loopmasta/rdio/README.md

# rdio

**rdio** turns your iPhone into a VHF/UHF radio. It connects to one or more ESP32-powered devices equipped with radio modules over Wi-Fi. Listen to transmissions, talk with push-to-talk, save your favourite channels and repeaters, and exchange APRS messages in a familiar chat-style interface.

**[Get the app on the App Store](https://apps.apple.com/de/app/rdio/id6831735571?l=en-GB)**

<table>
  <tr>
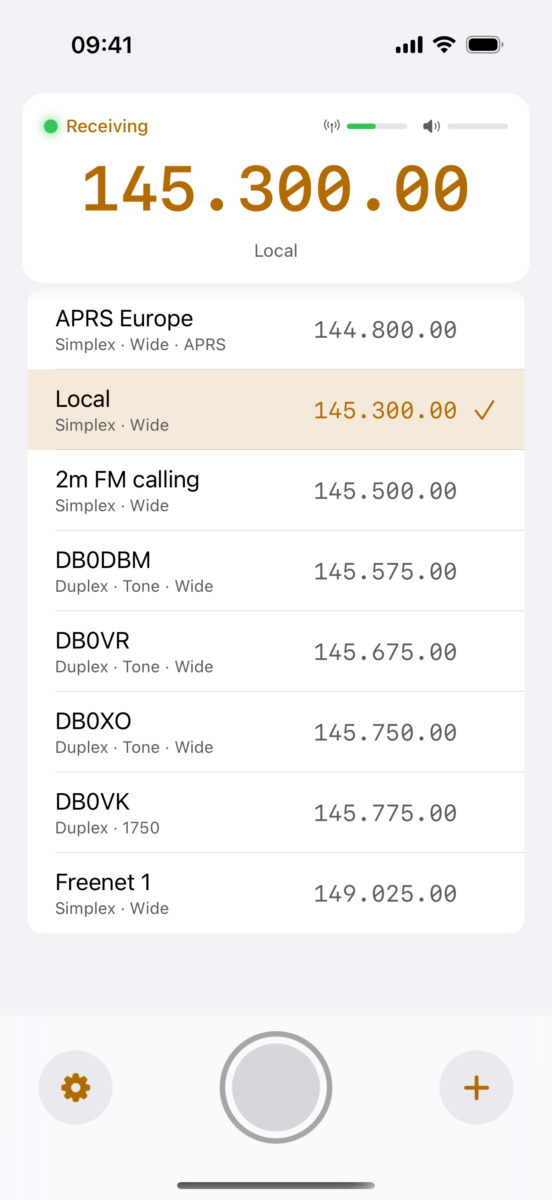
[picture p1: docs/1-main.png]
Main screen: frequency, signal and audio meters, channel list
    <td align="center"></td>
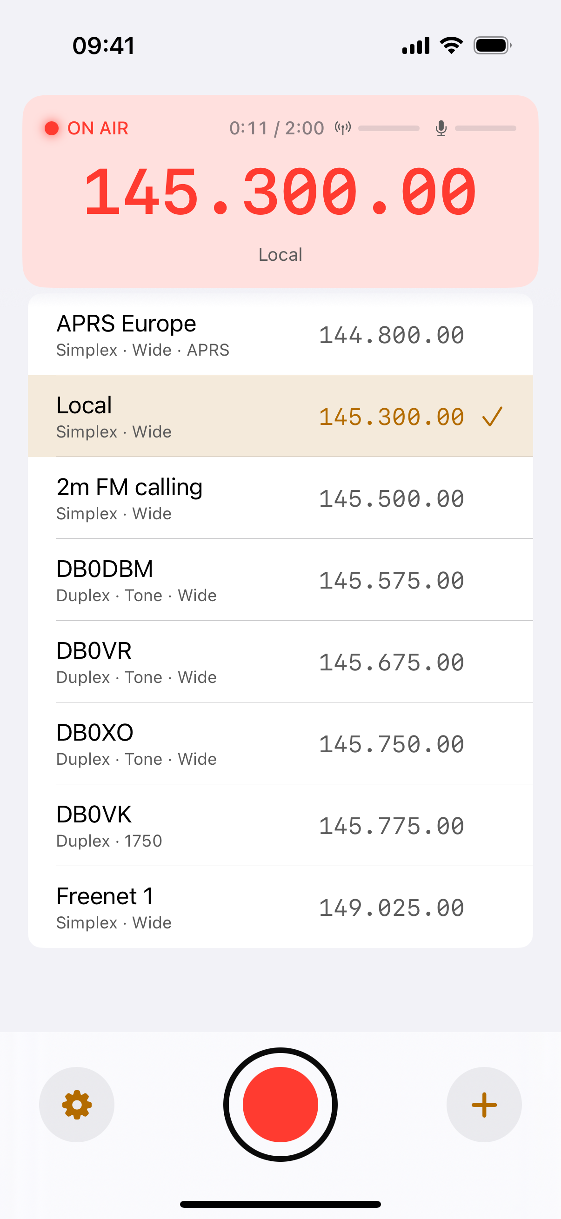
[picture p2: docs/2-transmit.png]
Transmitting: push-to-talk
    <td align="center"></td>
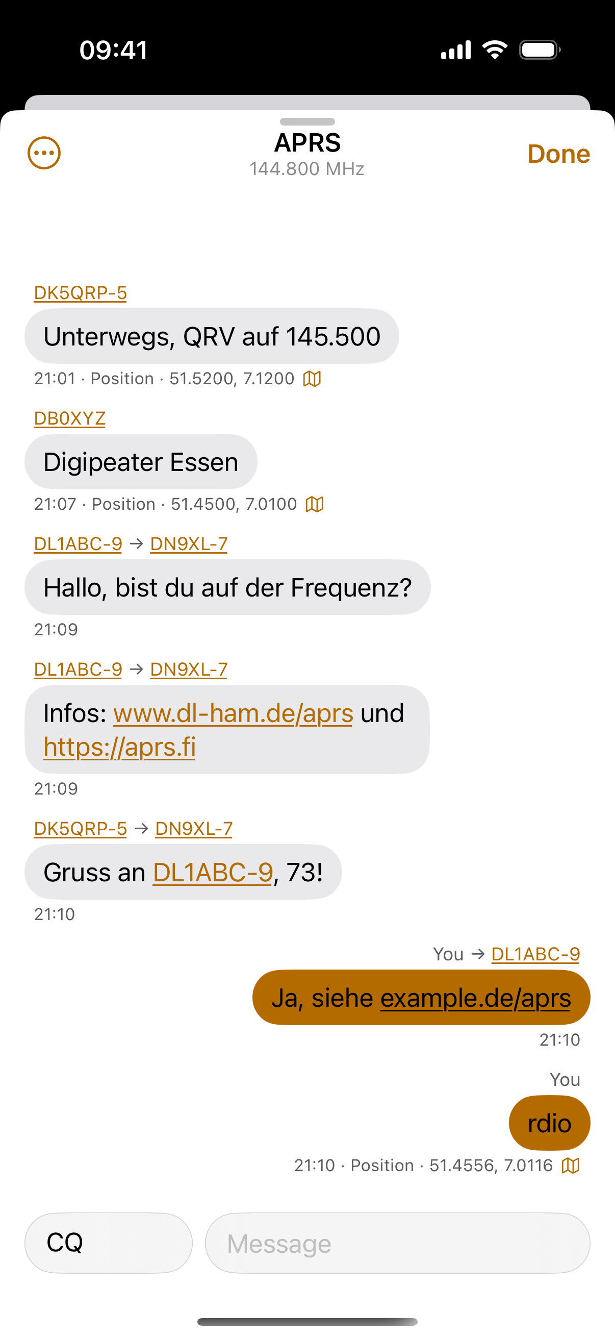
[picture p3: docs/3-aprs.png]
APRS chat with heard stations
    <td align="center"></td>
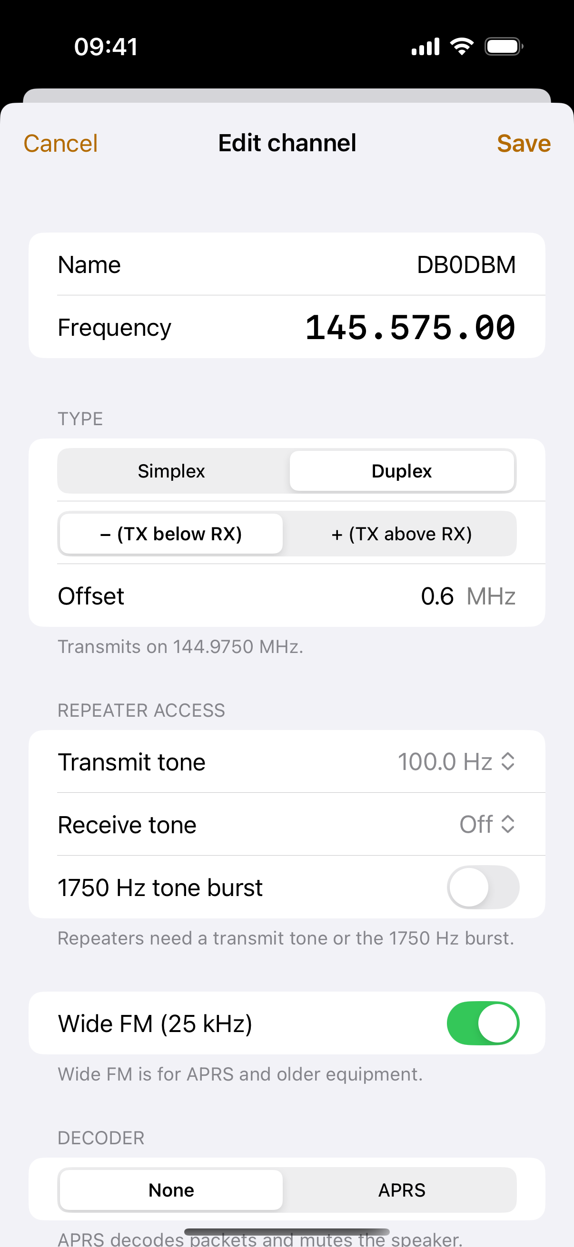
[picture p4: docs/4-editor.png]
Channel editor: frequency, simplex or duplex, tones, tone burst
    <td align="center"></td>
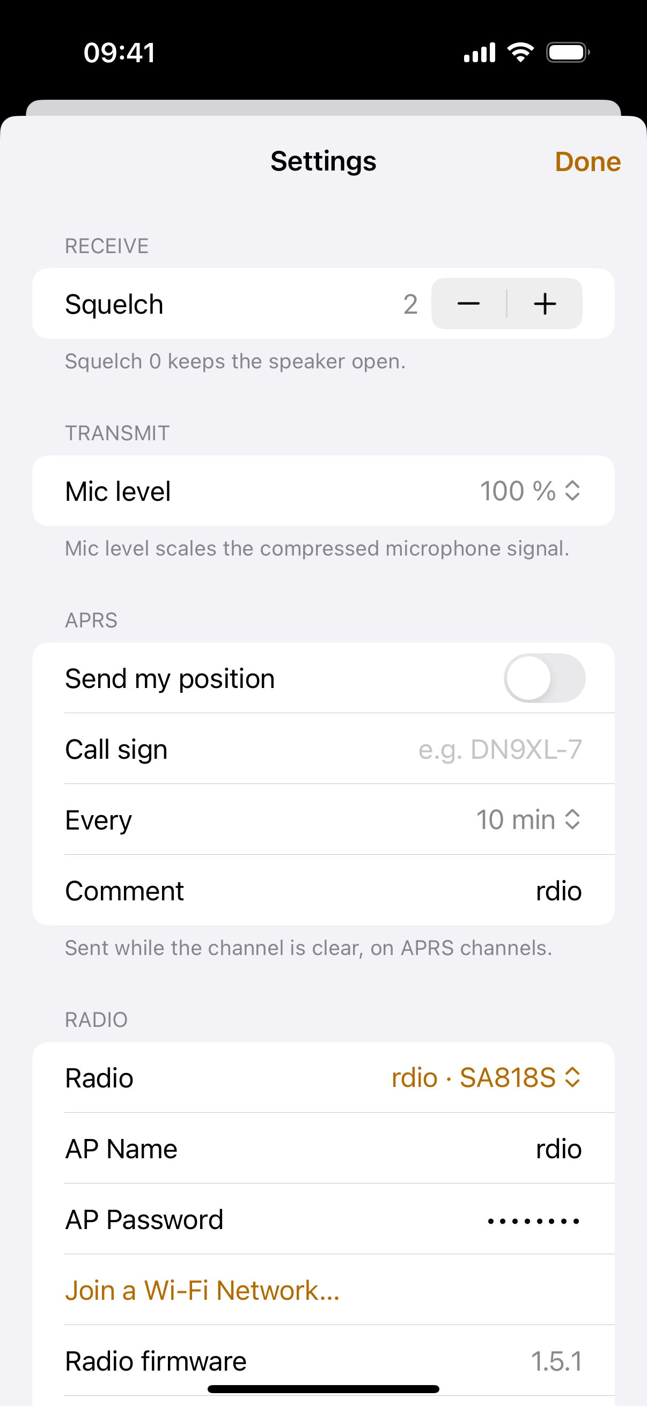
[picture p5: docs/5-settings.png]
Settings sheet: APRS beacon and radio
    <td align="center"></td>
  </tr>
  <tr>
    <td align="center">Main screen</td>
    <td align="center">Transmit</td>
    <td align="center">APRS chat</td>
    <td align="center">Channel editor</td>
    <td align="center">Settings</td>
  </tr>
</table>

## How it works

- The ESP32 opens its own Wi-Fi network (or joins one you configure). The phone connects to it and talks to the radio over a WebSocket. Radios on a shared network are found automatically (Bonjour), so one app can control several of them.
- Receive audio goes from the radio to the phone as 16 kHz mono PCM. Transmit audio goes the other way while you hold the push-to-talk button.
- The module is tuned, squelched and keyed by the ESP32 through its UART, PTT and power-down lines.
- Bluetooth is not used.

## Features

- **Receive and transmit** in the selected band (VHF 134–174 MHz or UHF 400–480 MHz).
- **Channel list** with simplex and duplex (repeater) entries, shift direction and offset, CTCSS transmit and receive tones, and a 1750 Hz tone burst. Reorder by dragging, swipe to edit or delete.
- **APRS** on 1200 baud AFSK: the app decodes received packets (positions, Mic-E, messages, status) on APRS channels, shows them as a chat with distance and a link to Maps, links call signs to QRZ.com. You can also send: type a message in the chat to a call sign or to CQ. Messages to a station are repeated until it acknowledges them, the app acknowledges messages addressed to you, and everything is sent only while the channel is clear. A periodic position beacon is available too.
- **Several radios:** each radio announces itself on the network as a Bonjour service (`_rdio._tcp`, with its name, module type and firmware version). The app lists the radios it finds in Settings → Radio and switches between them with one tap. Give every radio its own name (Settings → Radio Name), because the name is also its Wi-Fi and host name.
- **Phone microphone chain** with a compressor and a mic level setting, soft limiter on the radio side.
- **Native iOS design**: system controls, Light and Dark Mode, Dynamic Type, VoiceOver, haptics, no navigation bar.
- **Transmit safety**: the app only transmits inside the selected band, and the firmware releases the push-to-talk line when the connection drops, when no audio arrives, and after 120 seconds. Only one client can transmit.
- **Transmit power:** high (1 W) or low (0.5 W) with a switch in Settings → Radio. The radio remembers the choice; low power draws about half as much from the battery while transmitting.
- Firmware updates over Wi-Fi.

## Status

Working on a real radio: receive, transmit, channel handling, tones, tone burst, APRS decoding, and the APRS position beacon (tested over the air).

Not done yet: a scan function in the app.

The carrier board is built and works: receive, transmit, the transmit audio level and the power switch were tested on the air. The harmonic filters below are **designed but not built or measured yet**. They are simulated only; check them with a NanoVNA before relying on them.

## Hardware

Everything is KiCad 10 and is generated by scripts, so the boards can be rebuilt and changed in code.

### Carrier board

A 57.3 × 25.4 mm two-layer board for an ESP32 38-pin DevKit (NodeMCU-32S style) and a DRA818 / SA818 module. The DevKit's own pins are soldered into the board from below, the radio module sits on the top side, and an SMA jack on the end opposite the DevKit's USB port carries the antenna signal on a short track.

<table>
  <tr>
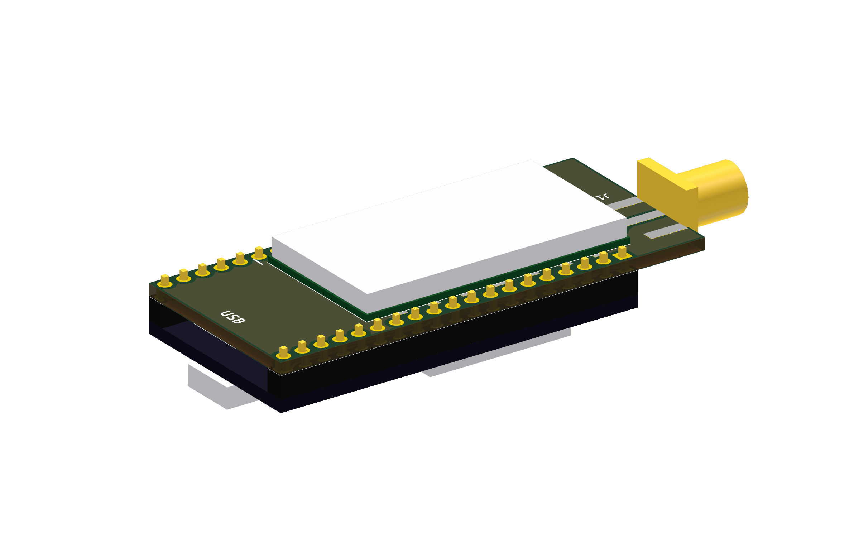
[picture p6: hardware/rdio-pcb-3d.png]
Top side of the carrier board with the radio module, the DevKit below and the SMA jack
    <td align="center"></td>
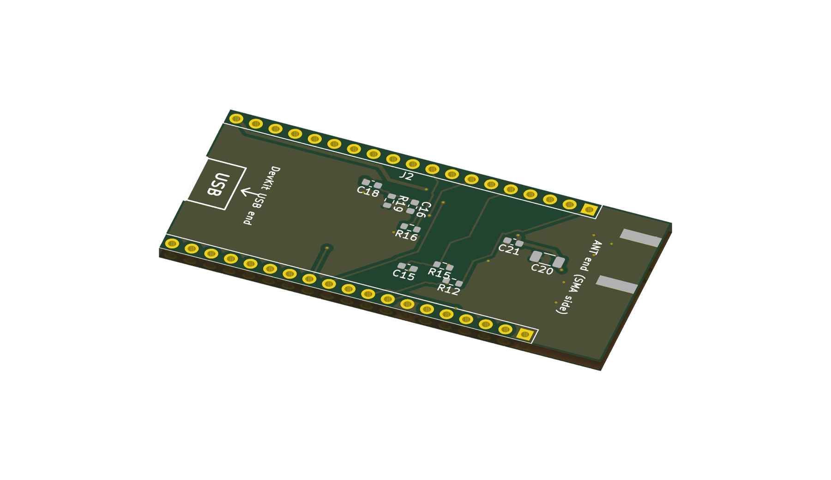
[picture p7: hardware/rdio-pcb-bottom.png]
Bottom side of the carrier board with the audio and supply parts and the DevKit pin rows
    <td align="center"></td>
  </tr>
  <tr>
    <td align="center">Top: radio module, DevKit below, SMA jack</td>
    <td align="center">Bottom: audio and supply parts, DevKit pin rows</td>
  </tr>
</table>

| Function | ESP32 pin |
|---|---|
| Module UART (RX / TX) | GPIO16 / GPIO17 |
| Power down (high = on) | GPIO19 |
| PTT (low = transmit) | GPIO18 |
| Squelch in | GPIO32 |
| RX audio in (ADC) | GPIO34, biased to 1.75 V by GPIO26 |
| TX audio out | GPIO25 |
| High / low power | GPIO23 (the firmware pulls it low for 0.5 W and leaves it floating for 1 W; it never drives it high) |

- The module's supply pin is fed straight from the DevKit's 5 V pin, with a 47 µF and a 100 nF capacitor next to the module. The module's datasheet allows 3.3 to 4.5 V, so check the voltage on your DevKit's 5 V pin (many boards drop it through a diode from USB) before the first power-up.
- Pin numbers, the module name and the antenna end are printed on the top silkscreen inside the module outline, to help with placing it.
- Test status: built and working. The module's footprint and the DevKit's pin spacing were checked against real parts. The transmit network (22 k in series, 220 Ω and 220 nF to ground) divides the signal by about 100 and rolls it off from a few hundred hertz, so the firmware compensates with a higher transmit gain and a first-order treble boost (`firmware/idf/main/board.h`); the level and the frequency response were checked through a second radio.

### Harmonic filters (2 m and 70 cm)

Two small all-SMD low-pass filters (7th-order Chebyshev, 0.1 dB ripple, 50 Ω) that go between the board's SMA jack and the antenna and cut the radio module's harmonics. Details, simulation and parts notes: [hardware/filter/README.md](hardware/filter/README.md).

<table>
  <tr>
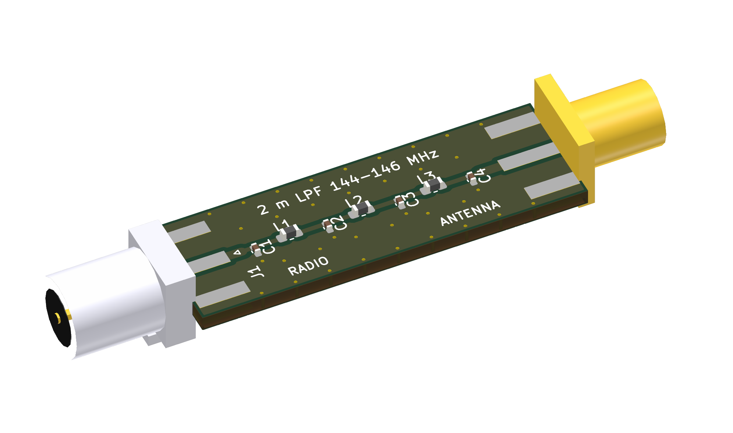
[picture p8: hardware/filter/vhf/rdio-filter-vhf-3d.png]
2 m low-pass filter board
    <td align="center"></td>
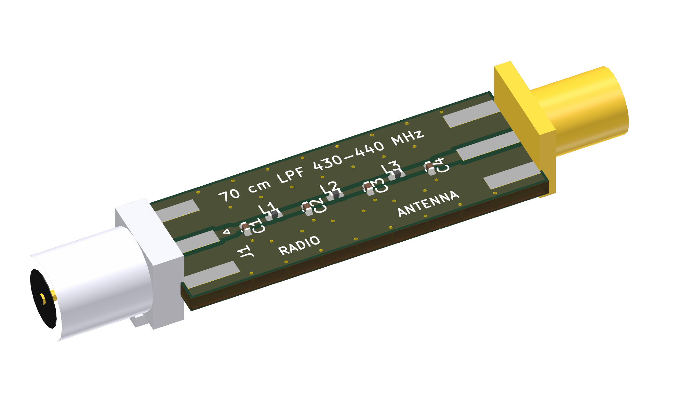
[picture p9: hardware/filter/uhf/rdio-filter-uhf-3d.png]
70 cm low-pass filter board
    <td align="center"></td>
  </tr>
  <tr>
    <td align="center">2 m, 144–146 MHz</td>
    <td align="center">70 cm, 430–440 MHz</td>
  </tr>
</table>

| | 2 m | 70 cm |
|---|---|---|
| Passband | 144–146 MHz | 430–440 MHz |
| Insertion loss (simulated) | 0.56 dB | 0.50 dB |
| 2nd harmonic (simulated) | 52 dB down | 63 dB down |
| Board size | 38.0 × 12.4 mm | 34.4 × 12.4 mm |

### Ordering the boards

Gerber, drill, bill of materials and placement files for JLCPCB are in [hardware/jlcpcb/](hardware/jlcpcb/): `radio/` for the carrier board and `filters/vhf`, `filters/uhf` for the filters. Check the LCSC part numbers in the bills of materials against JLCPCB's parts library before you order. The SMA connectors, the DevKit headers and the radio module are soldered by hand.

## Legal

Transmitting needs an amateur radio licence and must follow the rules that apply to you. The app limits the transmit frequency to the selected band, but you are responsible for staying within your licence and the local regulations.

**Privacy:** the app has no accounts, analytics or tracking. See the [privacy policy](https://loopmasta.github.io/rdio/privacy/).

## Repository contents

This repository lets a small group of testers order the hardware, build it, flash the firmware and install the app, with no software knowledge or development tools. It holds the hardware design (`hardware/`), the screenshots (`docs/`) and this description.

The software is not included and does not need to be built:

- **iOS app:** [download rdio from the App Store](https://apps.apple.com/de/app/rdio/id6831735571?l=en-GB).
- **Firmware:** installed from your browser with the [web flasher](https://loopmasta.github.io/rdio/flash/). Connect the ESP32 over USB, open the page in Chrome or Edge on a computer and press install.
