loopmasta/rdio/hardware/filter/uhf/rdio-filter-uhf-top.png

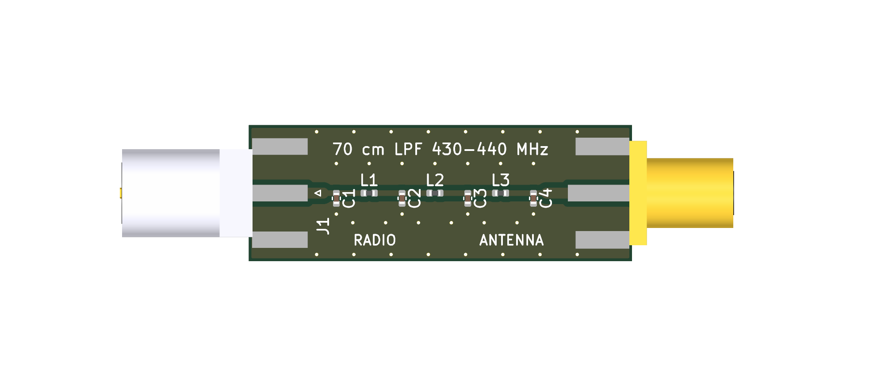
hardware/filter/uhf/rdio-filter-uhf-top.png
