loopmasta/rdio/hardware/rdio-pcb-top.png

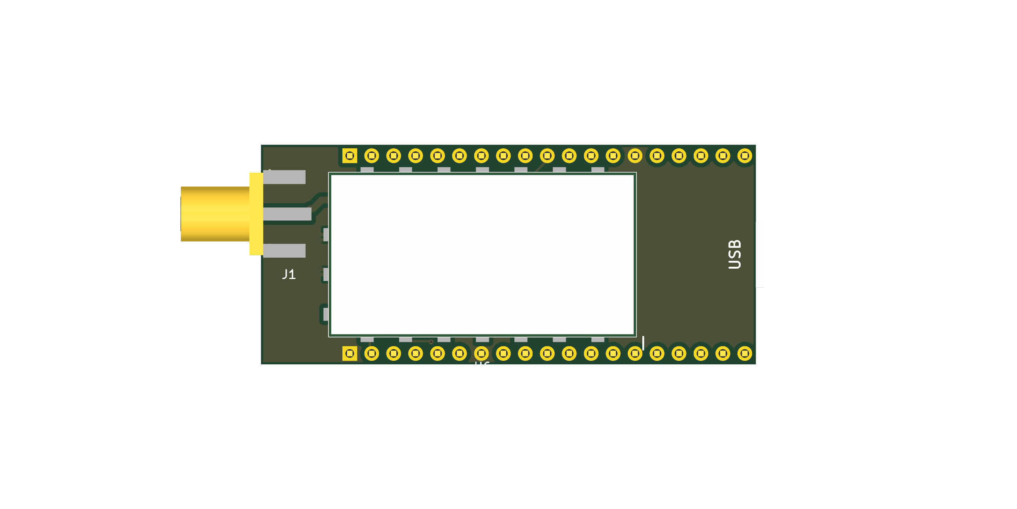
hardware/rdio-pcb-top.png
