loopmasta/rdio/hardware/jlcpcb/radio/bom.csv

Comment | Designator | Footprint | LCSC Part #
1uF | C15 | C_0603_1608Metric | C15849
220nF | C16 | C_0603_1608Metric | C23630
100nF | C18,C21 | C_0603_1608Metric | C14663
47uF | C20 | C_1206_3216Metric | C96123
10k | R12,R15 | R_0603_1608Metric | C25804
22k | R16 | R_0603_1608Metric | C31850
220R | R19 | R_0603_1608Metric | C22962
