loopmasta/rdio/hardware/rdio-schematic.pdf

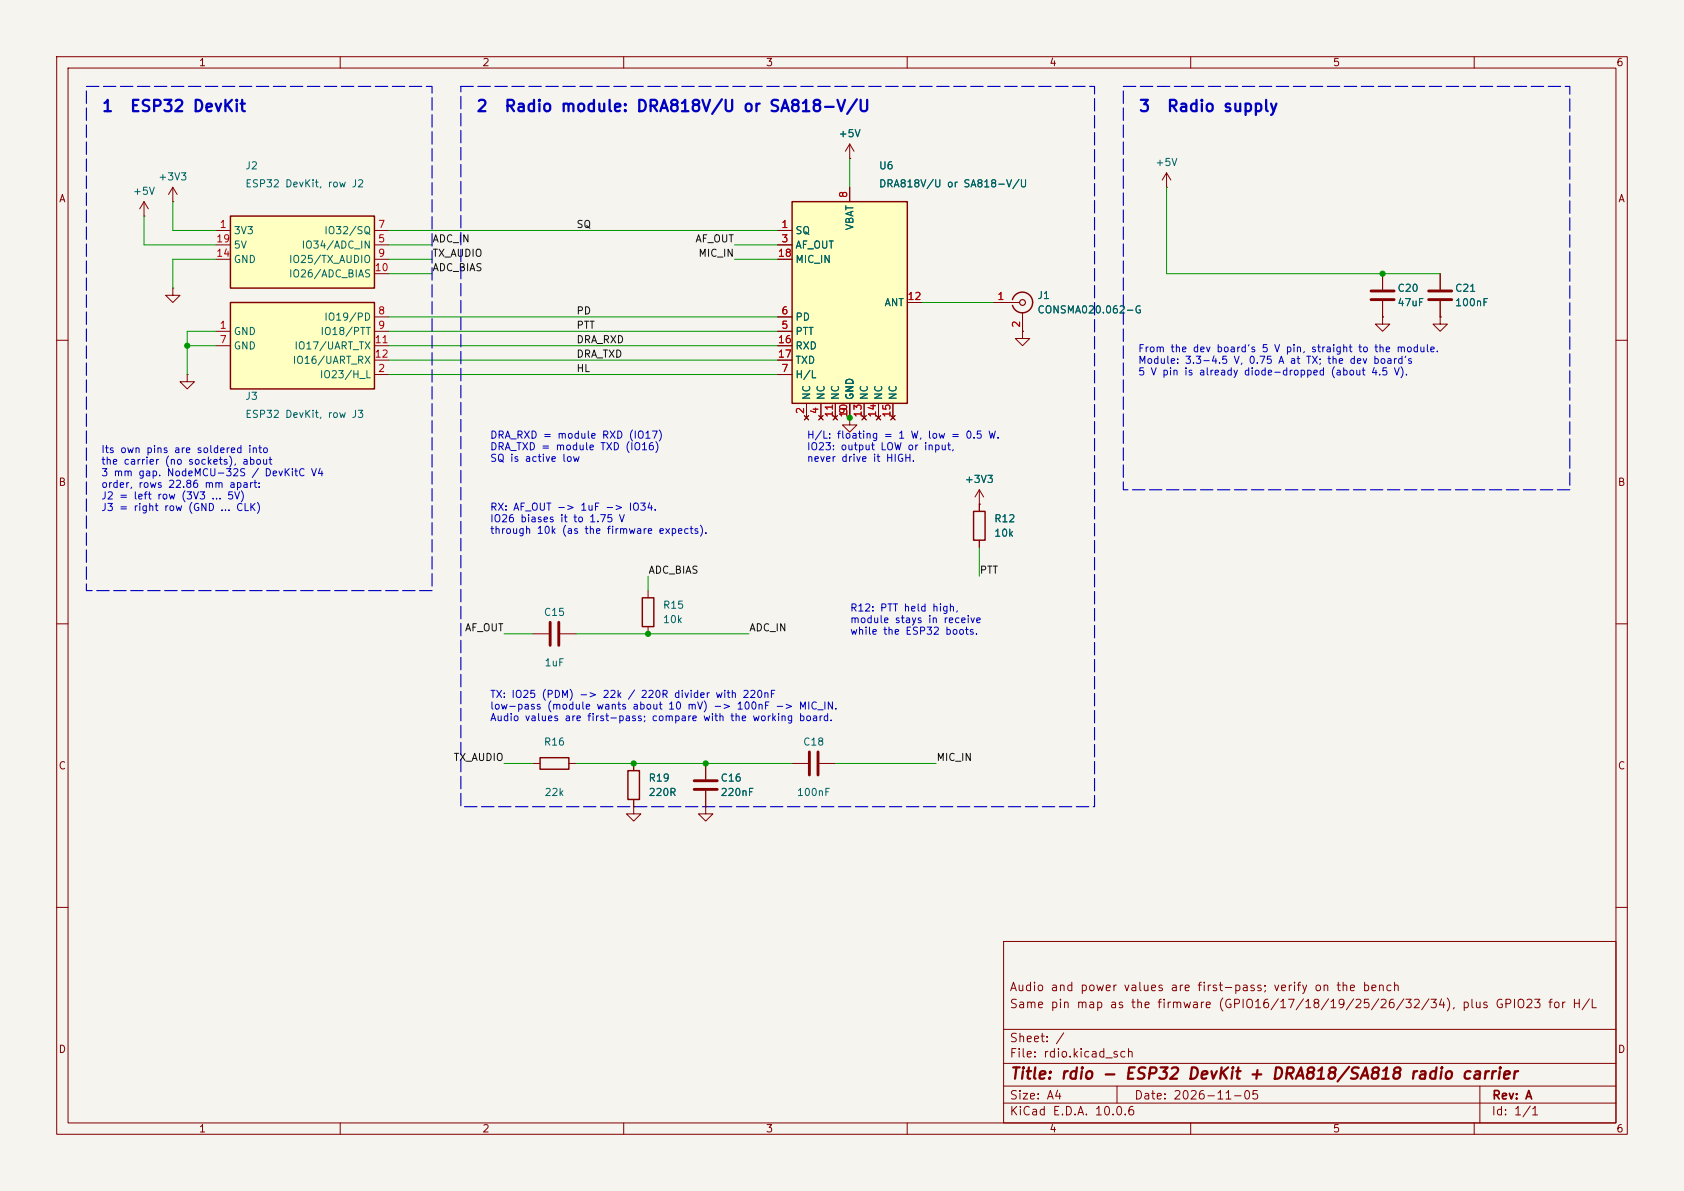
[picture p14: page 1]

4 PTT 5 PD 6 H/L 7 VBAT 8 GND

Its own pins are soldered into
the carrier (no sockets), about 3 mm gap. NodeMCU-32S / DevKitC V4

IO23: output LOW or input, never drive it HIGH. TX: IO25 (PDM) -> 22k / 220R divider with 220nF

R12: PTT held high, module stays in receive while the ESP32 boots. RX: AF_OUT -> 1uF -> IO34.
IO26 biases it to 1.75 V

low-pass (module wants about 10 mV) -> 100nF -> MIC_IN. Audio values are first-pass; compare with the working board.

Audio and power values are first-pass; verify on the bench
Same pin map as the firmware (GPIO16/17/18/19/25/26/32/34), plus GPIO23 for H/L

Sheet: /
File: rdio.kicad_sch
Title: rdio - ESP32 DevKit + DRA818/SA818 radio carrier

Size: A4 | Rev: A
KiCad E.D.A. 10.0.6 | Id: 1/1
