loopmasta/rdio/hardware/filter/uhf/rdio-filter-uhf-schematic.pdf

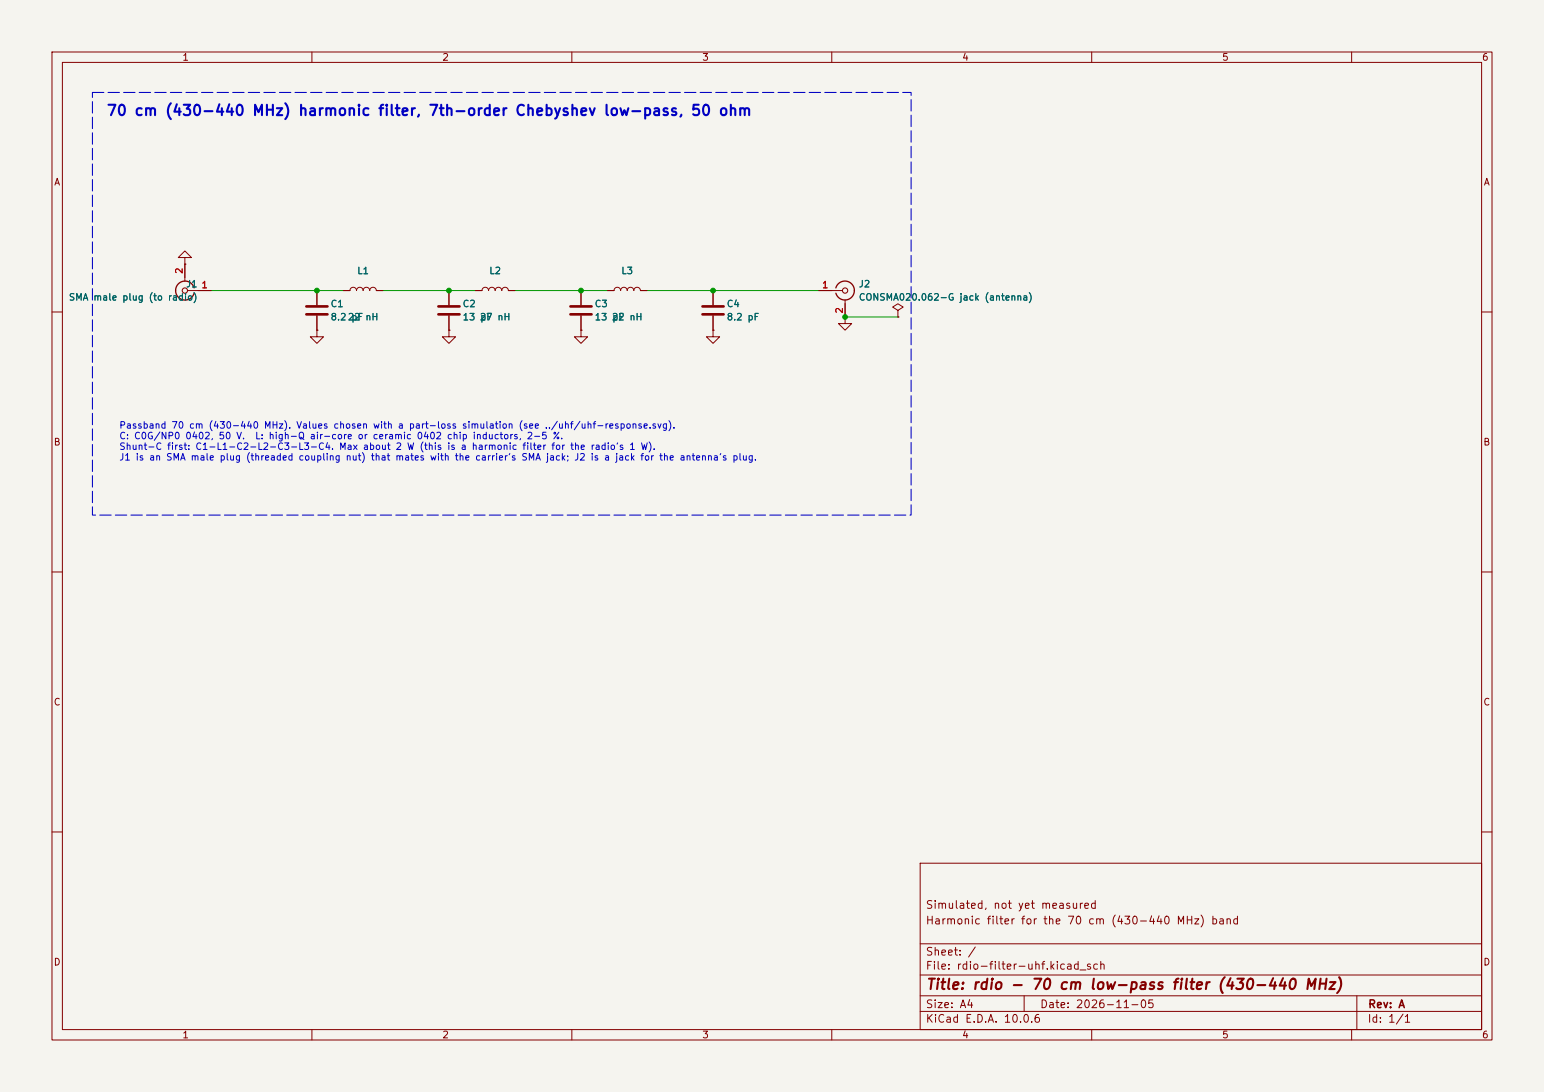
[picture p15: page 1]

22 nH 70 cm (430-440 MHz) harmonic filter, 7th-order Chebyshev low-pass, 50 ohm

Passband 70 cm (430-440 MHz). Values chosen with a part-loss simulation (see ../uhf/uhf-response.svg). C: C0G/NP0 0402, 50 V. L: high-Q air-core or ceramic 0402 chip inductors, 2-5 %. Shunt-C first: C1-L1-C2-L2-C3-L3-C4. Max about 2 W (this is a harmonic filter for the radio's 1 W). J1 is an SMA male plug (threaded coupling nut) that mates with the carrier's SMA jack; J2 is a jack for the antenna's plug. L1

Simulated, not yet measured
Harmonic filter for the 70 cm (430-440 MHz) band

Sheet: /
File: rdio-filter-uhf.kicad_sch
Title: rdio - 70 cm low-pass filter (430-440 MHz)

Size: A4 | Rev: A
KiCad E.D.A. 10.0.6 | Id: 1/1
