loopmasta/rdio/hardware/filter/vhf/rdio-filter-vhf-schematic.pdf

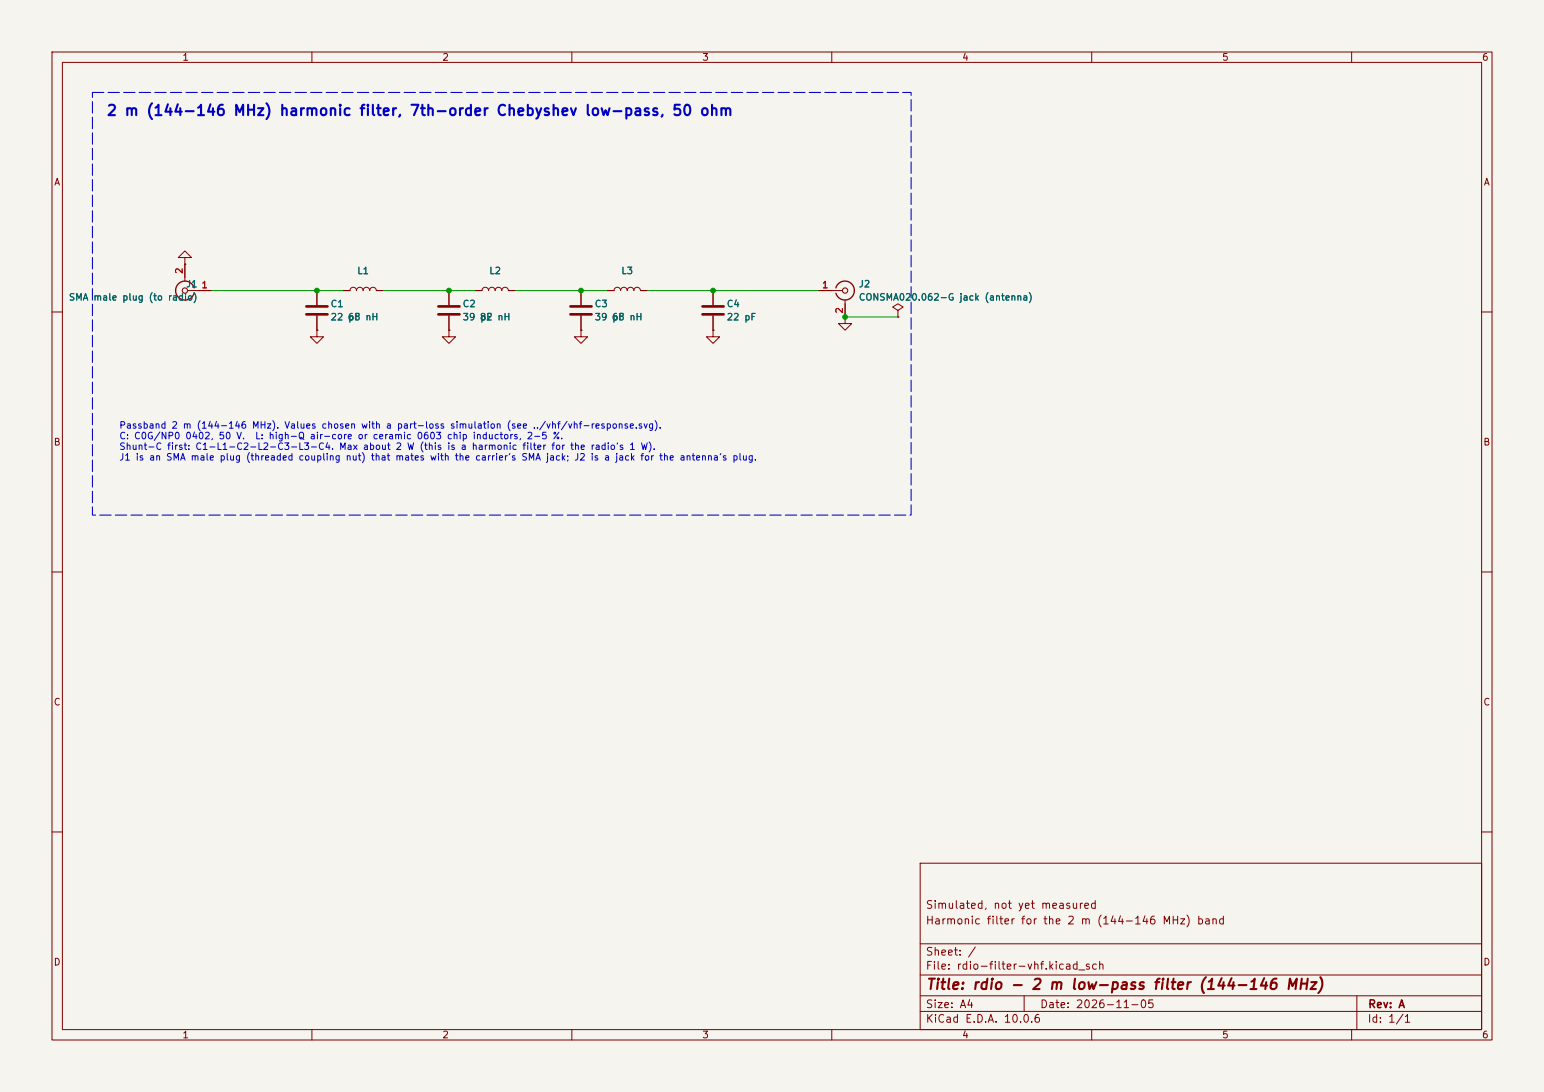
[picture p16: page 1]

2 m (144-146 MHz) harmonic filter, 7th-order Chebyshev low-pass, 50 ohm

Passband 2 m (144-146 MHz). Values chosen with a part-loss simulation (see ../vhf/vhf-response.svg). C: C0G/NP0 0402, 50 V. L: high-Q air-core or ceramic 0603 chip inductors, 2-5 %. Shunt-C first: C1-L1-C2-L2-C3-L3-C4. Max about 2 W (this is a harmonic filter for the radio's 1 W). J1 is an SMA male plug (threaded coupling nut) that mates with the carrier's SMA jack; J2 is a jack for the antenna's plug. C1

Simulated, not yet measured
Harmonic filter for the 2 m (144-146 MHz) band

Sheet: /
File: rdio-filter-vhf.kicad_sch
Title: rdio - 2 m low-pass filter (144-146 MHz)

Size: A4 | Rev: A
KiCad E.D.A. 10.0.6 | Id: 1/1
