loopmasta/rdio/hardware/rdio.kicad_pcb

## KiCad design hardware/rdio.kicad_pcb (2026-11-06)

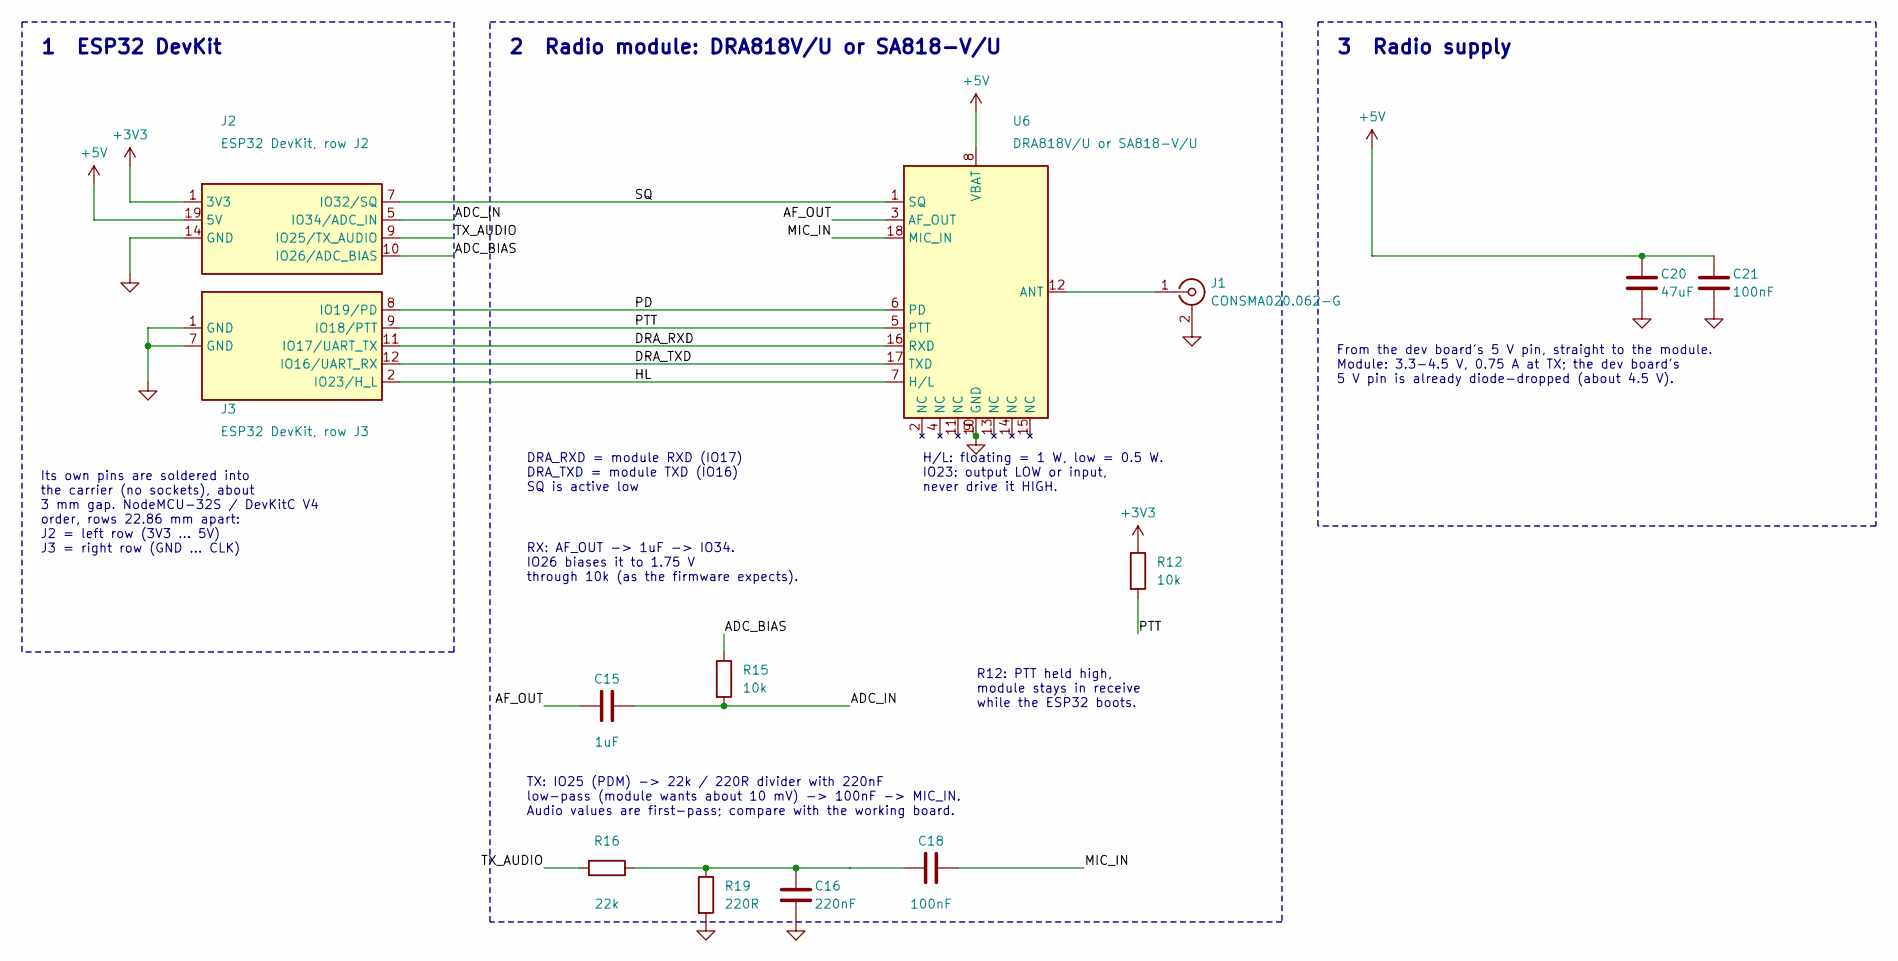
[picture p17: schematic rdio.kicad_sch, rdio - ESP32 DevKit + DRA818/SA818 radio carrier]

Parts:
C15: 1uF; C_0603_1608Metric
C16: 220nF; C_0603_1608Metric
C18, C21: 100nF; C_0603_1608Metric
C20: 47uF; C_1206_3216Metric
J1: CONSMA020.062-G; CONSMA020_062_G
J2: ESP32 DevKit, row J2; PinHoles_1x19_P2.54mm
J3: ESP32 DevKit, row J3; PinHoles_1x19_P2.54mm
R12, R15: 10k; R_0603_1608Metric
R16: 22k; R_0603_1608Metric
R19: 220R; R_0603_1608Metric
U6: DRA818V/U or SA818-V/U; DRA818_SA818

Connections:
+3V3: J2.1 (3V3), R12.1
+5V: C20.1, C21.1, J2.19 (5V), U6.8 (VBAT)
/ADC_BIAS: J2.10 (IO26/ADC_BIAS), R15.1
/ADC_IN: C15.2, J2.5 (IO34/ADC_IN), R15.2
/AF_OUT: C15.1, U6.3 (AF_OUT)
/DRA_RXD: J3.11 (IO17/UART_TX), U6.16 (RXD)
/DRA_TXD: J3.12 (IO16/UART_RX), U6.17 (TXD)
/HL: J3.2 (IO23/H_L), U6.7 (H/L)
/MIC_IN: C18.2, U6.18 (MIC_IN)
/PD: J3.8 (IO19/PD), U6.6 (PD)
/PTT: J3.9 (IO18/PTT), R12.2, U6.5 (PTT)
/SQ: J2.7 (IO32/SQ), U6.1 (SQ)
/TX_AUDIO: J2.9 (IO25/TX_AUDIO), R16.1
GND: C16.2, C20.2, C21.2, J1.2 (Ext), J2.14 (GND), J3.1 (GND), J3.7 (GND), R19.2, U6.9 (GND), U6.10 (GND)
unnamed: C16.1, C18.1, R16.2, R19.1
unnamed: J1.1 (In), U6.12 (ANT)

Notes on the sheet:
1 ESP32 DevKit
Its own pins are soldered into the carrier (no sockets), about 3 mm gap. NodeMCU-32S / DevKitC V4 order, rows 22.86 mm apart: J2 = left row (3V3 ... 5V) J3 = right row (GND ... CLK)
2 Radio module: DRA818V/U or SA818-V/U
DRA_RXD = module RXD (IO17) DRA_TXD = module TXD (IO16) SQ is active low
H/L: floating = 1 W, low = 0.5 W. IO23: output LOW or input, never drive it HIGH.
R12: PTT held high, module stays in receive while the ESP32 boots.
RX: AF_OUT -> 1uF -> IO34. IO26 biases it to 1.75 V through 10k (as the firmware expects).
TX: IO25 (PDM) -> 22k / 220R divider with 220nF low-pass (module wants about 10 mV) -> 100nF -> MIC_IN. Audio values are first-pass; compare with the working board.
3 Radio supply
From the dev board's 5 V pin, straight to the module. Module: 3.3-4.5 V, 0.75 A at TX; the dev board's 5 V pin is already diode-dropped (about 4.5 V).

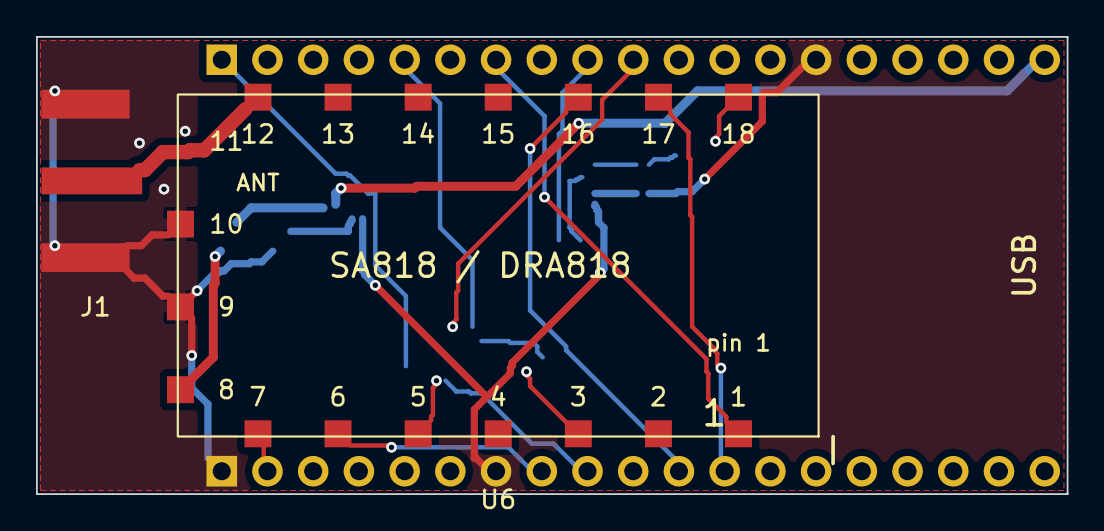
[picture p18: board rdio.kicad_pcb from above]

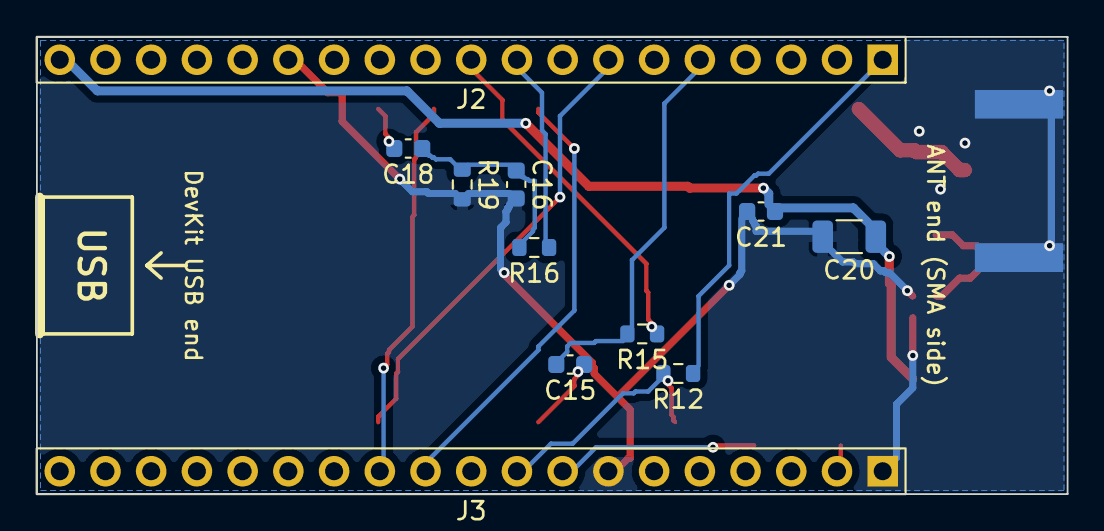
[picture p19: board rdio.kicad_pcb from below]

Board: 2 copper layers, 57.3 x 25.4 mm, 14 parts (11 on the bottom side), 16 nets.

Other parts of the board:
DK1: ESP32_DevKit_38pin
