loopmasta/rdio/hardware/filter/uhf/rdio-filter-uhf.kicad_pcb

## KiCad design hardware/filter/uhf/rdio-filter-uhf.kicad_pcb (2026-11-06)

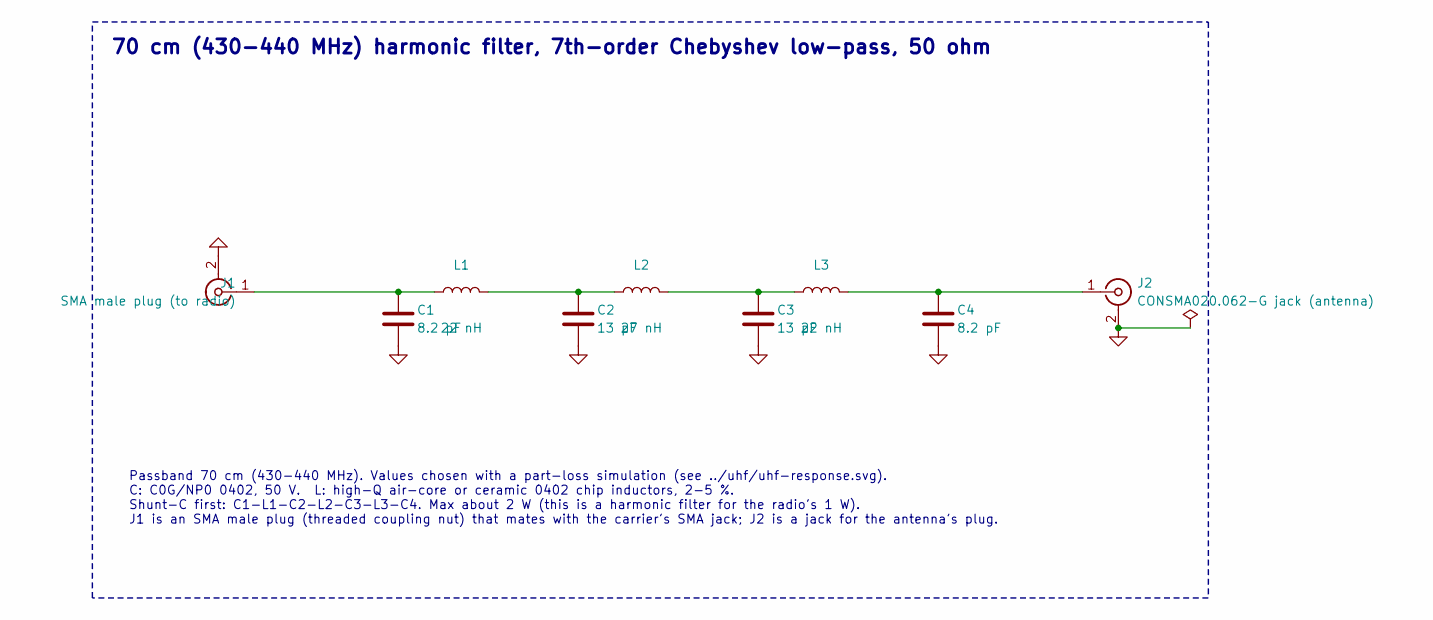
[picture p20: schematic rdio-filter-uhf.kicad_sch, rdio - 70 cm low-pass filter (430-440 MHz)]

Parts:
C1, C4: 8.2 pF; C_0402_1005Metric
C2, C3: 13 pF; C_0402_1005Metric
J1: SMA male plug (to radio); SMA_Plug_EdgeMount
J2: CONSMA020.062-G jack (antenna); CONSMA020_062_G
L1, L3: 22 nH; L_0402_1005Metric
L2: 27 nH; L_0402_1005Metric

Connections:
GND: C1.2, C2.2, C3.2, C4.2, J1.2 (Ext), J2.2 (Ext)
unnamed: C2.1, L1.2, L2.1
unnamed: C3.1, L2.2, L3.1
unnamed: C1.1, J1.1 (In), L1.1
unnamed: C4.1, J2.1 (In), L3.2

Notes on the sheet:
70 cm (430-440 MHz) harmonic filter, 7th-order Chebyshev low-pass, 50 ohm
Passband 70 cm (430-440 MHz). Values chosen with a part-loss simulation (see ../uhf/uhf-response.svg). C: C0G/NP0 0402, 50 V. L: high-Q air-core or ceramic 0402 chip inductors, 2-5 %. Shunt-C first: C1-L1-C2-L2-C3-L3-C4. Max about 2 W (this is a harmonic filter for the radio's 1 W). J1 is an SMA ma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

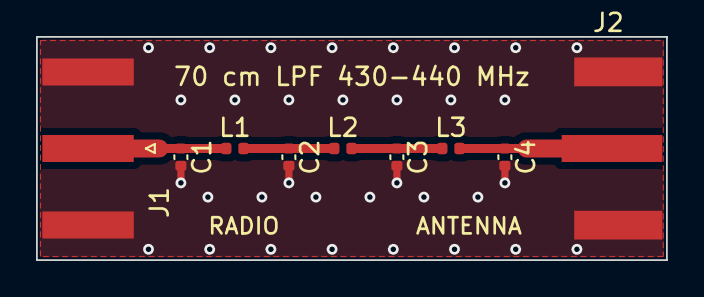
[picture p21: board rdio-filter-uhf.kicad_pcb from above]

Board: 2 copper layers, 35.0 x 12.4 mm, 9 parts (0 on the bottom side), 5 nets.
