loopmasta/rdio/(commit log)

2026-11-06 Add README, hardware design and screenshots
    [bom.csv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]
2026-11-07 README: several radios via Bonjour, status update
    - The app finds radios on a shared network (Bonjour service _rdio._tcp) and
    switches between them in Settings -> Radio; radios need unique names.
    - Status: the APRS beacon has been tested over the air.
    - The microphone chain is a compressor and a mic level setting (the
    high-pass filter is gone).
2026-11-08 Web flasher: identify lights the LED once
2026-11-11 README: power switch, carrier board built and tested
    Transmit power feature, the status text (the carrier board works; only the filters are still unbuilt), the GPIO23 row and a test note
    on the transmit network and how the firmware compensates for it.
2026-11-11 Web flasher: firmware 2.1.0 with the power switch
